gbhug5a/Daily_Check-In_Device/Pictures/CheckIn2.jpg

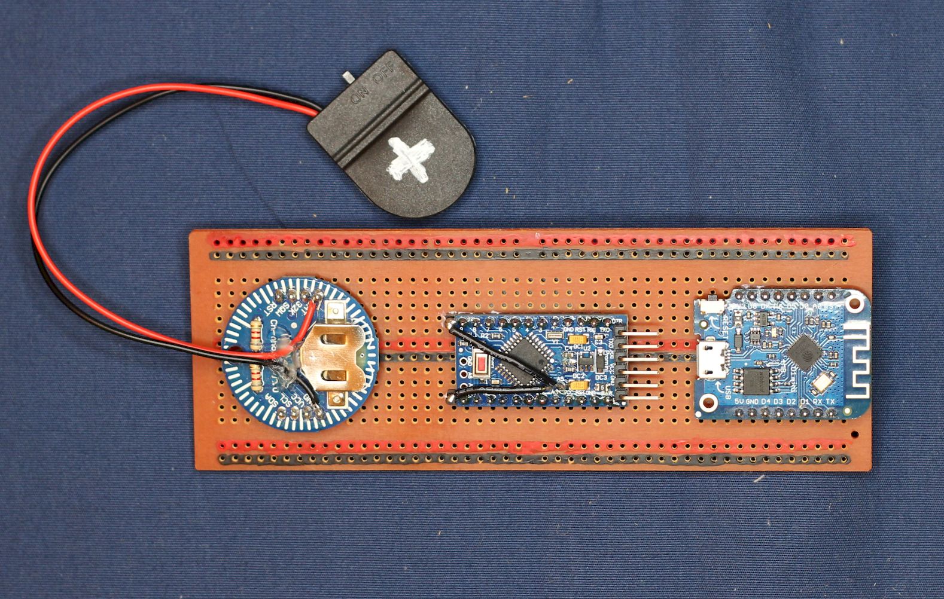
Pictures/CheckIn2.jpg
