gbhug5a/Daily_Check-In_Device/Pictures/CheckIn3.jpg

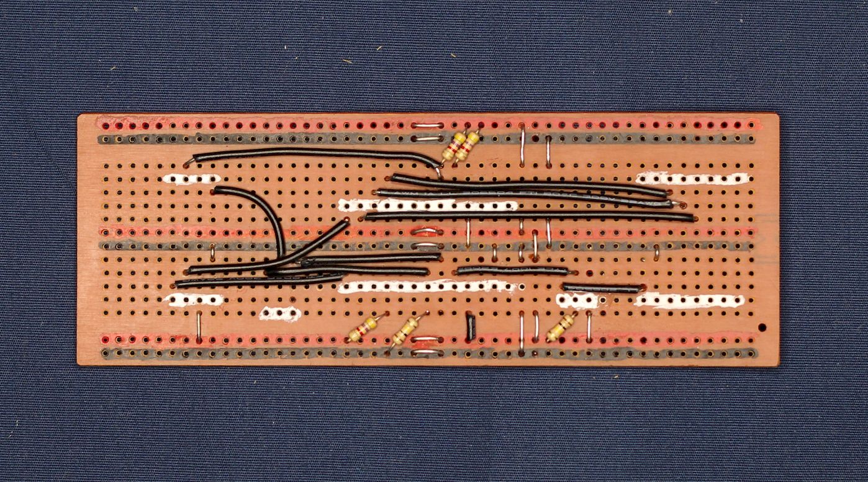
Pictures/CheckIn3.jpg
