gbhug5a/Daily_Check-In_Device/Daily Check-In Device - schematic.png

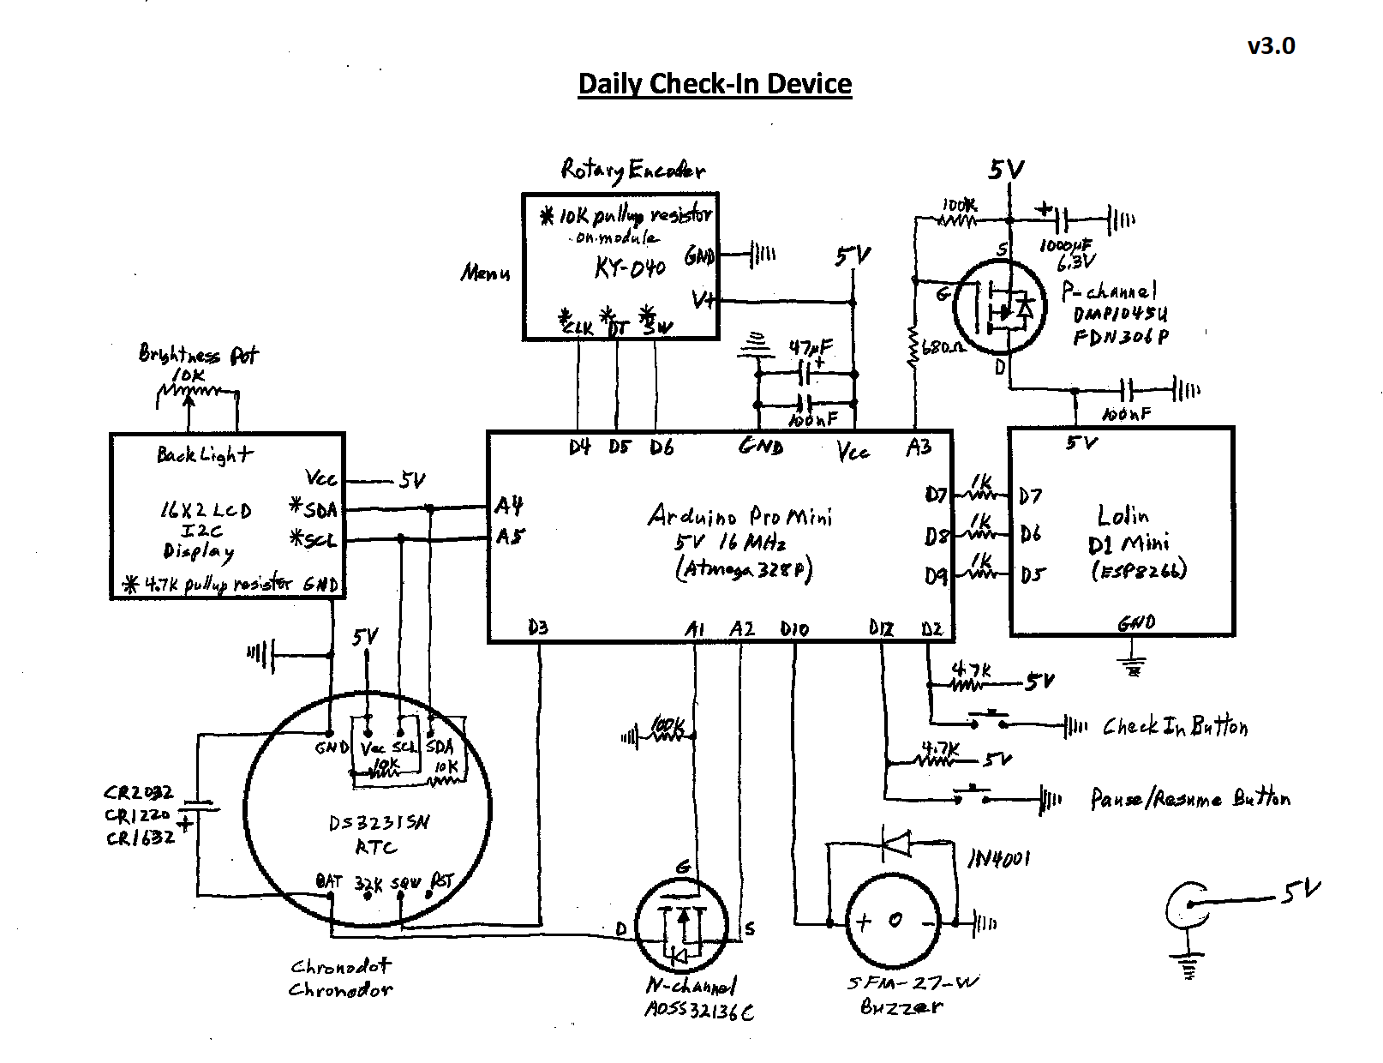
Daily Check-In Device - schematic.png
