gbhug5a/Daily_Check-In_Device/Pictures/CheckIn1.jpg

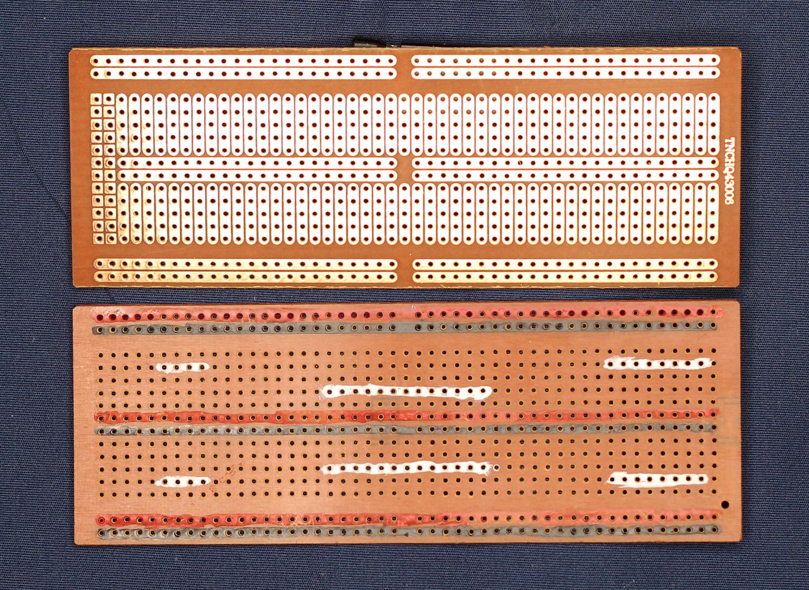
Pictures/CheckIn1.jpg
