gbhug5a/Daily_Check-In_Device/Pictures/Checkin4.jpg

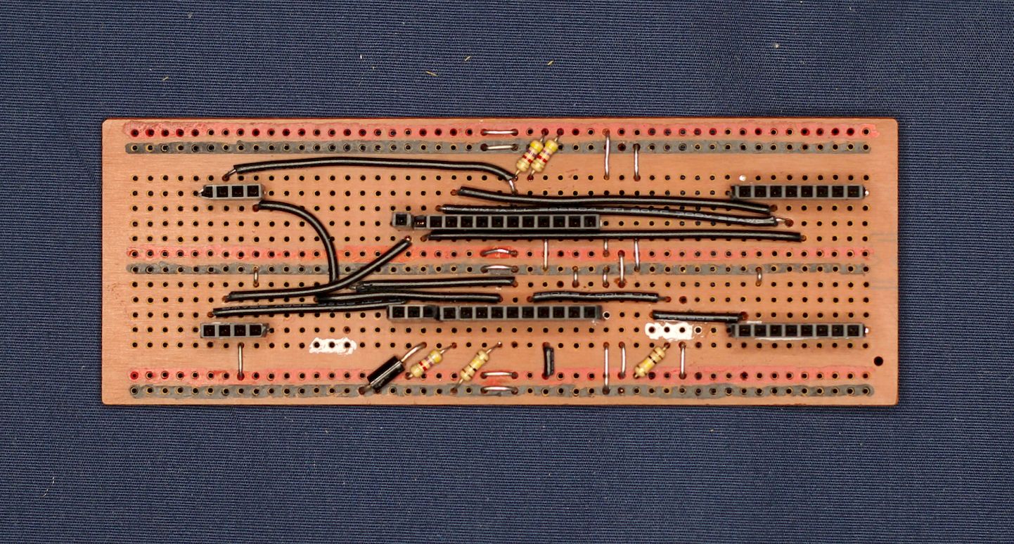
Pictures/Checkin4.jpg
