gbhug5a/Daily_Check-In_Device/Pictures/Checkin5.jpg

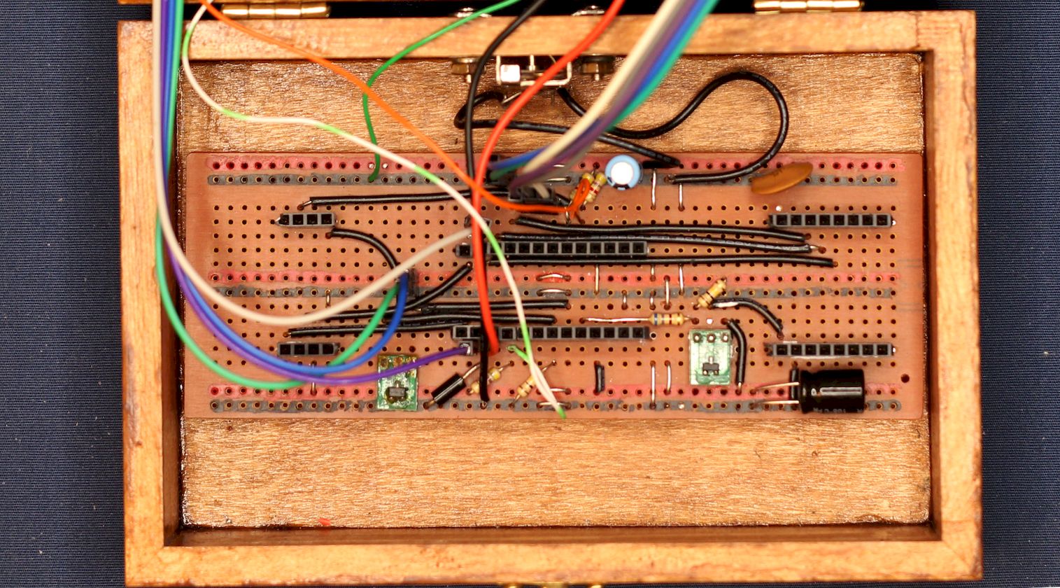
Pictures/Checkin5.jpg
