gbhug5a/Daily_Check-In_Device/Pictures/Checkin6.jpg

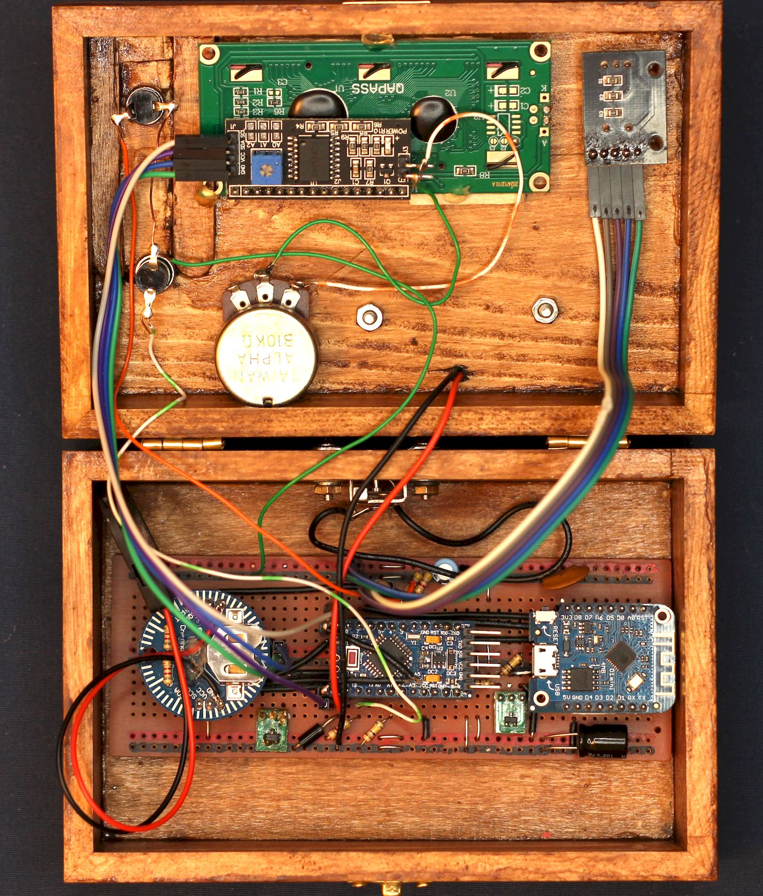
Pictures/Checkin6.jpg
