gbhug5a/Daily_Check-In_Device/Pictures/Checkin7.jpg

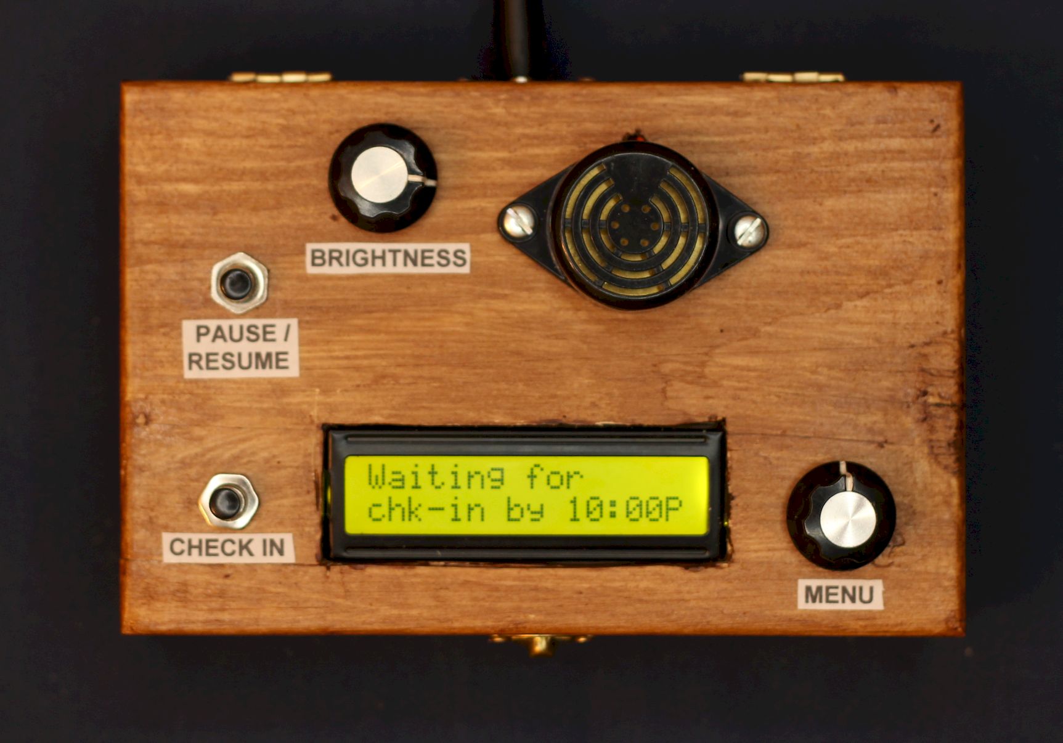
Pictures/Checkin7.jpg
